YannikW/Open-Lap/docs/Transponder Update.md

#Transponder Update

In this tutorial I will show you how to update your transponder if necessary.

1. Hardware needed
2. Install ATtiny support for Arduino
3. Configure upload options
4. Connect transponder and upload
5. Configure Fusebits (only for new transponders)

Note : All pictures shows the german version of Arduino, but I think you will understand what to do ;)

##1. Hardware needed

1. [USBASP](http://www.ebay.de/itm/AVR-51-Programmer-Adapter-mit-10-Pin-Kabel-ATMega-ATTiny-USBASP-USBISP-/301687762189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) (or - more complicated - [Arduino ISP](https://www.arduino.cc/en/Tutorial/ArduinoISP))
2. [AVX 6Pin Connector](http://www.mouser.de/Search/ProductDetail.aspx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)
3. A transponder to update :P

If you use a Windows system you have to install the correct driver for the USBASP. You can find it [here](http://www.fischl.de/usbasp/). There's also a link with a description how to install this driver on Win 8 and above - this will cause problems because of driver signature.

Also you have to solder the 10 (or 6) pin cable correct to the 6 pins of connector.  
Connect the cable to the connector like showen in this picture : 

Red numbers are cable/pin number for normal 10 pin ISP connector (like the USBASP has). Green numbers are for 6 pin ISP connector.
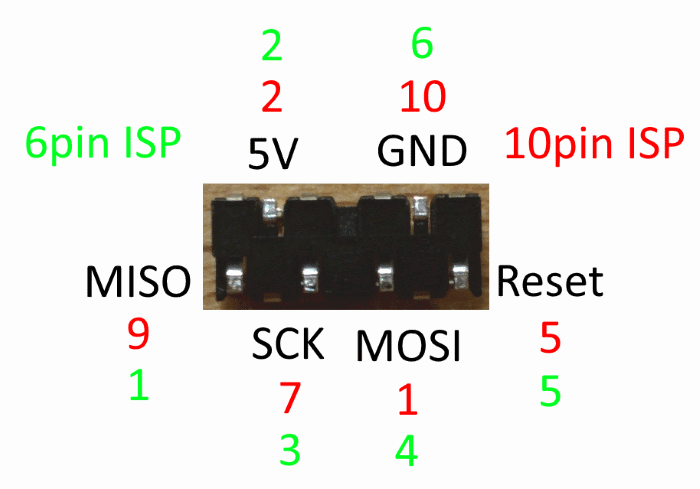
[picture p12: docs/pictures/Transponder Update/AVX Connector.png]


If you dont know which cable is pin one, you can look at your ISP connector. On one side there's a small triangle. The side with the tiangle is pin one. (In this case black cable is pin one, white pins two, ...)
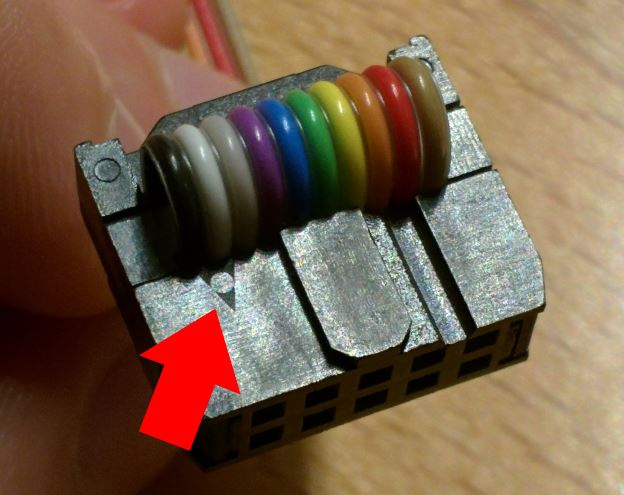
[picture p13: docs/pictures/Transponder Update/pin 1 mark.jpg]


Your soldered connector should look like this :
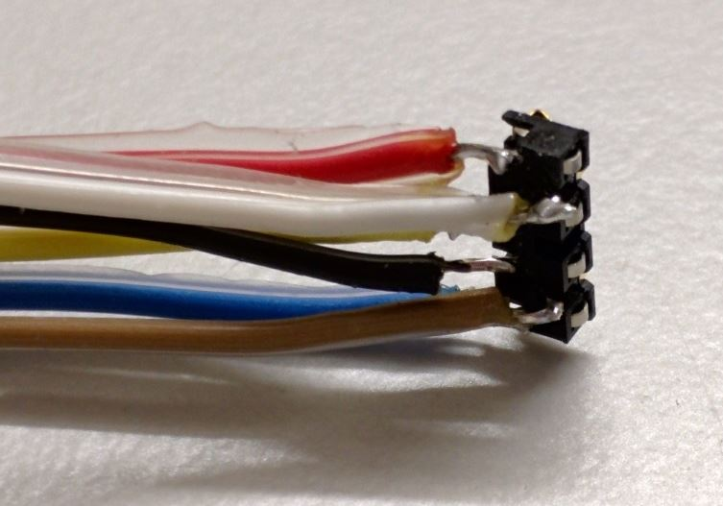
[picture p14: docs/pictures/Transponder Update/connector with cables.jpg]


For better usability I put some hot glue and shrink tube on the cables.
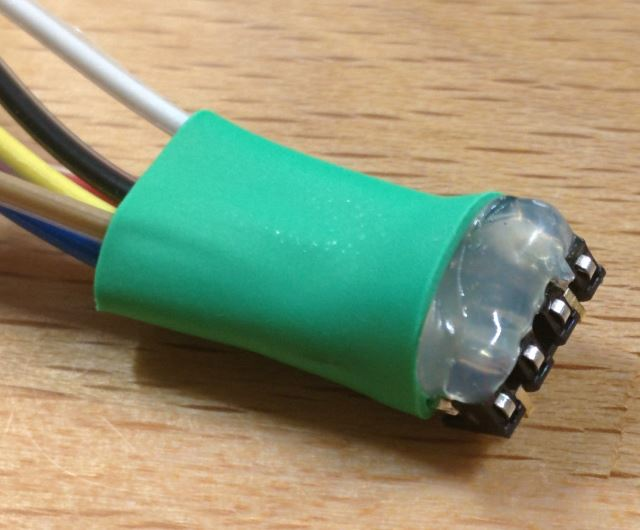
[picture p15: docs/pictures/Transponder Update/hot glue.jpg]
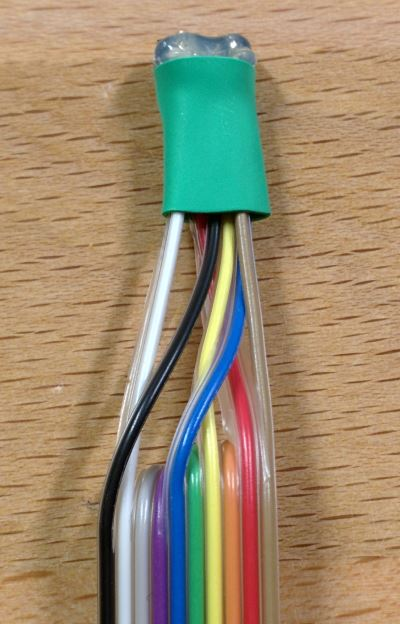
[picture p16: docs/pictures/Transponder Update/wiring.jpg]
 

##2. Install ATtiny support for Arduino

Note : You only have to do this once. If you already have ATtiny support installed you can go to step 3.

#####Open preferences  



#####Add following URL to "Additional Boards Manager URLs" (use a comma to separate it from any URLs you've already added)  
````
https://raw.githubusercontent.com/damellis/attiny/ide-1.6.x-boards-manager/package_damellis_attiny_index.json
````


#####Open Board Manager



#####Search for `attiny by David A. Mellis` and click on `Install`

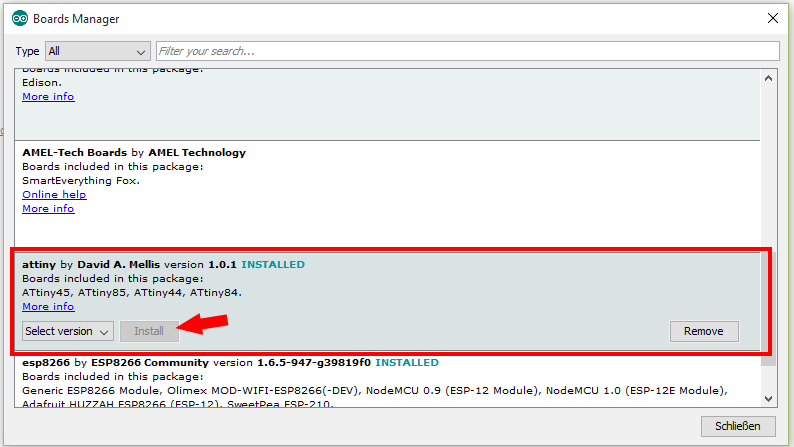
[picture p17: docs/pictures/Transponder Update/04 Board Manager.png]


Now you have successfully installed ATtiny support for Arduino.

##3. Configure upload options

#####Select following board options  
````
Board : ATtiny
Processor : ATtiny44
Clock : 16MHz (external)

Programmer : USBasp (if you use the one shown above)
````

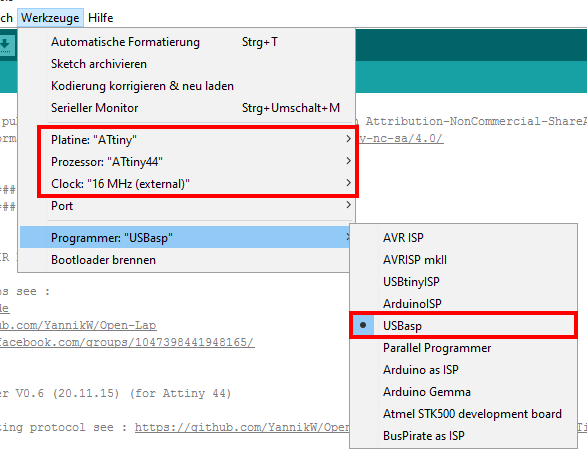
[picture p18: docs/pictures/Transponder Update/05 Auswahl.png]


##4. Connect transponder and upload

#####Place programmer on the pcb

[ToDo picture]

Note : If you programm a factory new attiny please do step 5 before uploading or the transponder won't work correctly. If you got a pre programmed transponder from me this step is already done.

#####Check if you have opened the newest TX sketch version and press upload

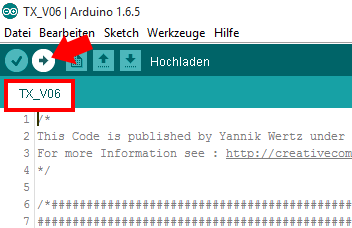
[picture p19: docs/pictures/Transponder Update/06 Upload.png]


#####If you done all right command line should look like this (Upload completed)

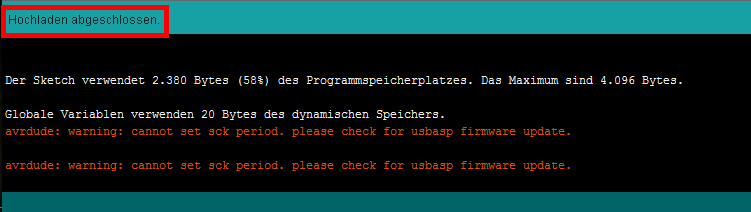
[picture p20: docs/pictures/Transponder Update/07 Upload abgeschlossen.png]


##5. Configure Fusebits

Note : If you got a pre programmed transponder from me this step is already done.

If you build a transponder yourselfe you have to change the fusebits.
On arduino this is done by the `burn bootloader` command. (The ATiny doesn't have a real bootloader like the ATmega. This command will only configure the fusebits.
Most of the fusebits will set correct bei arduino but one setting has to be changed.
Default arduino doesn't activate brownout detection. Brownout detection reset the controller automatic when voltage drops under a specific value. I recomend to set this value to 2.7V.
Without brownout detection it can happen that the transponder won't boot correct and has to be restartet. Because you can't see the IR light you won't notice that the transponder don't work. 
To activate brownout detection open
````
C:\Users\Yannik\AppData\Local\Arduino15\packages\attiny\hardware\avr\1.0.1\boards.txt
````
Note : Change your username ;)
AppData is a hidden folder. You can access it by serching for `%appdata%`.

In this file search the line
````
attiny.menu.clock.external16.bootloader.high_fuses=0xdf
````
and change to
````
attiny.menu.clock.external16.bootloader.high_fuses=0xdd
````

Then connect transponder via ISP and `burn bootloader`.
After that you have to reupload the sketch.
