YannikW/Open-Lap/Transponder/Hardware/Changelog Transponder Hardware.md

#Changelog

##Transponder Hardware

#####V0.6 (19.10.15)
  - four leds to indicate band / ID
  - button to change band / ID

#####V0.3
Note : V0.3 not longer supported by software
  - attiny 44 based
  - ID selection by solderjumper
  - IR led pulsed at ~200mA
