YannikW/Open-Lap/Transponder/Software/Changelog Transponder.md

#Changelog

##Transponder

#####V0.6 (20.11.15)
  - compatibility with Open LapTime Protocol
  - Now 60 IDs can be selected (1-63, except 16, 32, 48)
  - compatible with V0.6 Transponder hardware
  - long button press change band (1: 1-15 / 2: 17-31 / 3: 33-47 / 4: 49-63)
  - on startup or bandchange, one to four leds will blink to indicate band. After two seconds blinking they will light solid and show ID within the band

#####V0.5 (14.10.15)
  - ID change by button press
  - compatible with V0.6 Transponder hardware
