YannikW/Open-Lap/Transponder/Hardware/Transponder V0.6 Schematic.pdf

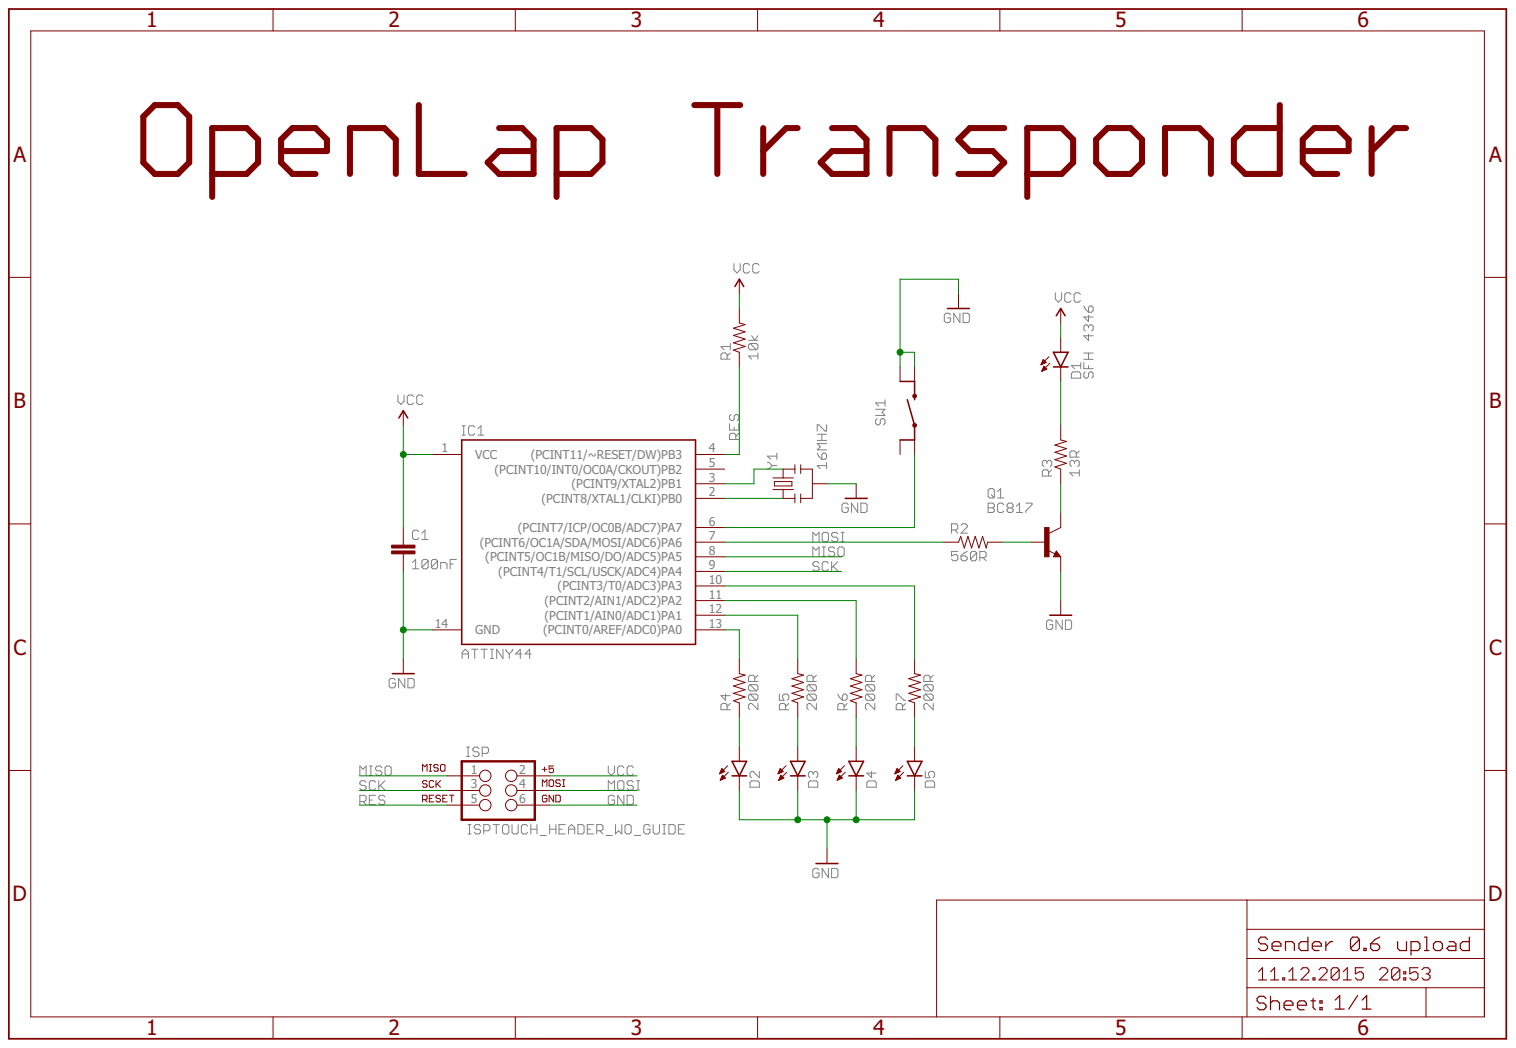
[picture p21: page 1]
