YannikW/Open-Lap/Receiver/Hardware/Receiver ESP V0.1.pdf

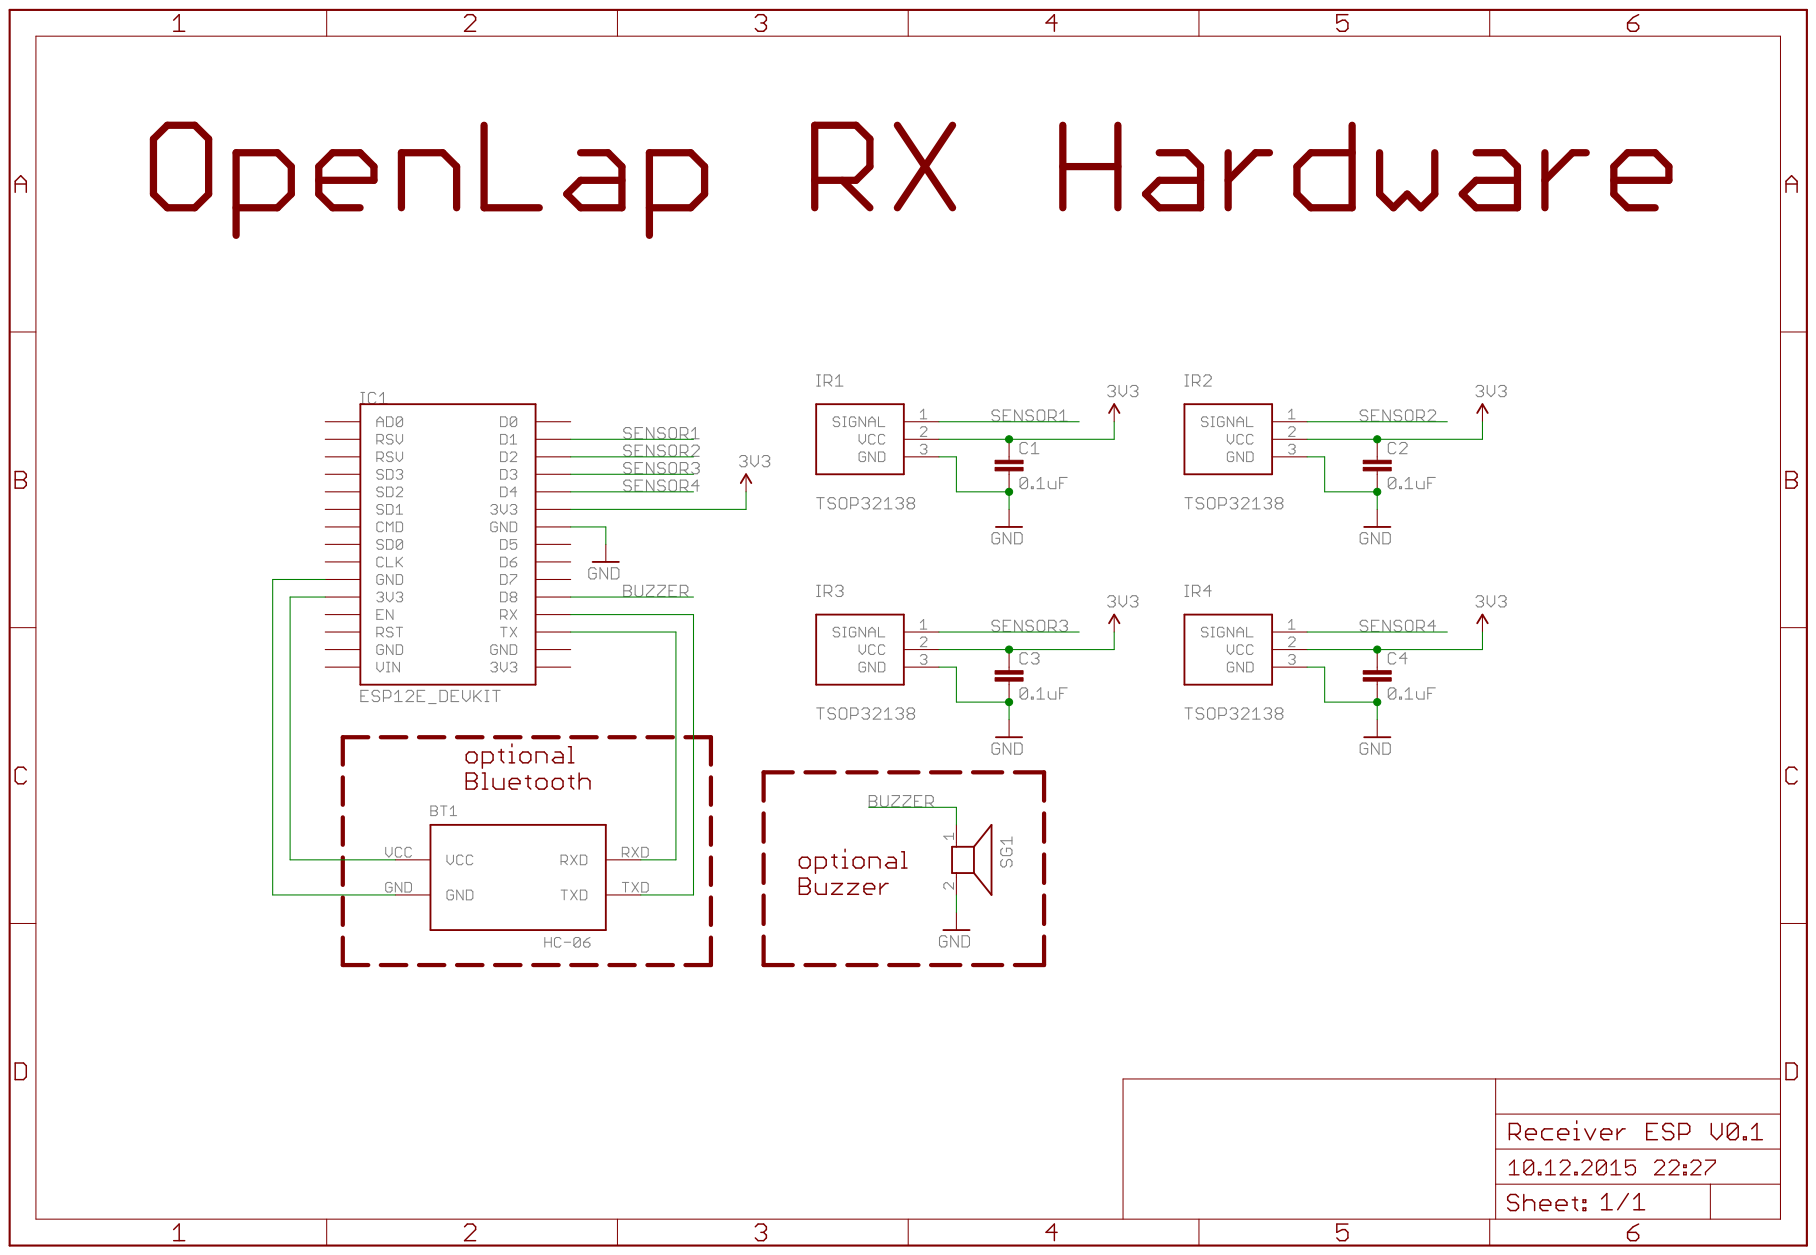
[picture p22: page 1]
