YannikW/Open-Lap/Receiver MS Arduino Version V0.1.pdf

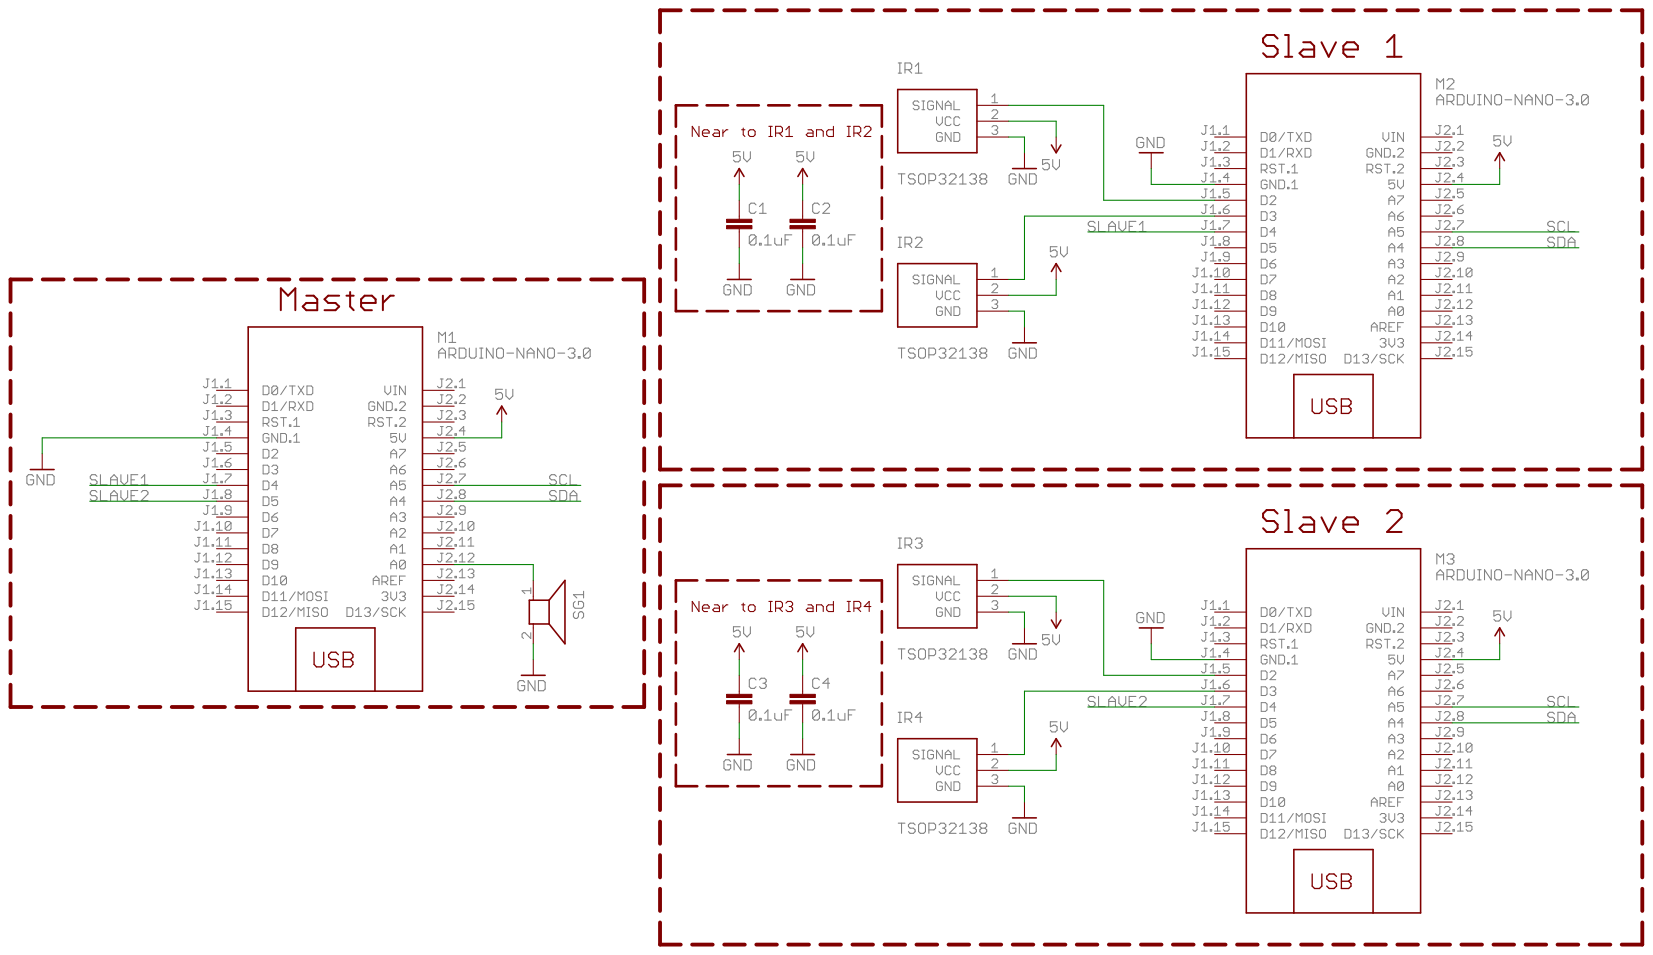
[picture p23: page 1]
