YannikW/Open-Lap/(commit log)

2015-09-06 Reset Flags were missing
    Code seems to work - Arduino can handle two sensors.
    [RX_V02.ino, RX_V03.ino]
2015-10-02 New code for new TSOP32138 sensor ad Attiny44 tx
2015-10-03 Added a rondom part in signalspace for colision avoidance
    [TX_V04.ino]
2015-10-24 New slave software V0.3 (single sensor)
2015-11-12 New TX with ID change by button (compatibel to V0.6 Transponder)
2015-11-24 update soldering avx connector
2015-12-07 add fusebit settings for brownout detection
2015-12-10 add new receiver hardware schematics
2015-12-11 add transponder schematic
2015-12-16 Add RX V0.6
    - FPV Race Tracker wireless
    - EasyRaceLapTimer wireless
    - software auto selection
2015-12-17 bugfix for newest arduino IDE -> add v0.6.1
    There were some bugs which made V0.6 not useable with Arduino IDE
    >=V1.6.6 - problem is fixed so V0.6.1 works with arduino 1.6.6 and 1.6.7
    too
    [Commands.ino, RX_ESP_V06.ino, RX_ESP_V061.ino, SerialCommand.cpp, SerialCommand.h]
2015-12-22 Add Transponder Software for Attiny85/45/25
    Special software version for ATTiny85/45/25 based transponder. IR LED
    connected to Pin 6 (PB1). Using internal 8Mhz clock.
